projectsoma/FW10/Planos/Adaptaciones/PlanoSM1.pdf

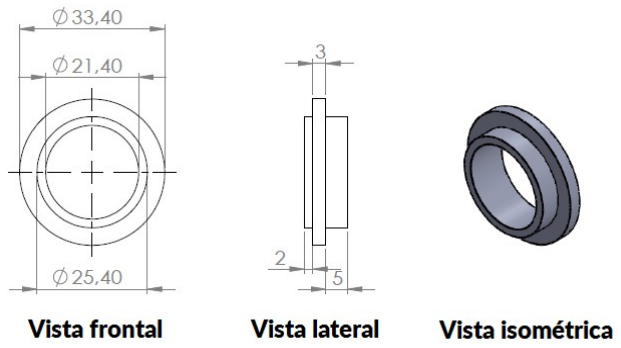
[picture p3: figure]

Adaptador SM1 - 1'
Escala | 1:1
Material | Aluminio
Medidas | Milímetros
