projectsoma/FW10/Planos/Bujes y Ejes/PlanoBujeExterno.PDF

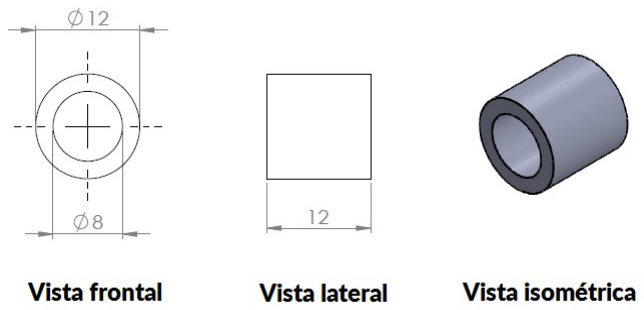
[picture p4: figure]

Buje Externo
Escala | 2:1
Material | Bronce
Medidas | Milímetros
