projectsoma/FW10/Planos/Bujes y Ejes/PlanoEjePinion.pdf

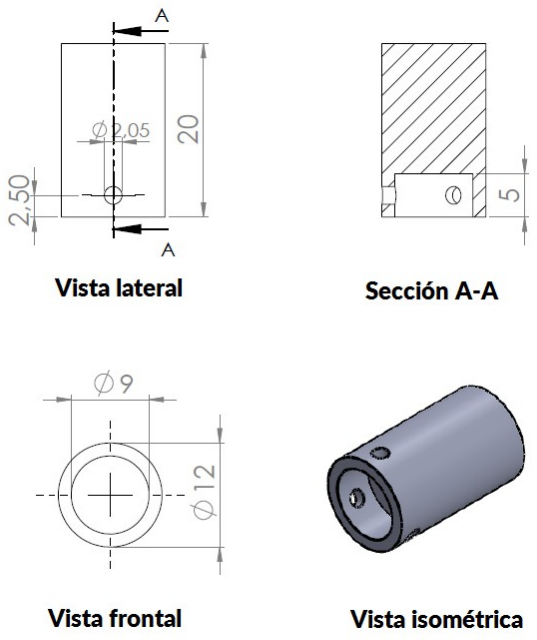
[picture p5: figure]

Eje Pinión - Motor
Escala | 2:1
Material | Bronce
Medidas | Milímetros
