projectsoma/FW10/Planos/Bujes y Ejes/PlanoEjeRueda.pdf

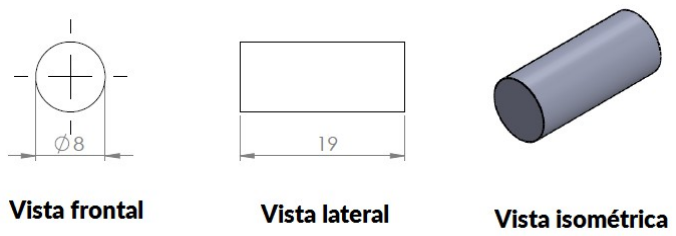
[picture p6: figure]

Eje Rueda
Escala | 2:1
Material | Bronce
Medidas | Milímetros
