projectsoma/FW10/Planos/Carcasa/PlanoContratapaCarcasa.pdf

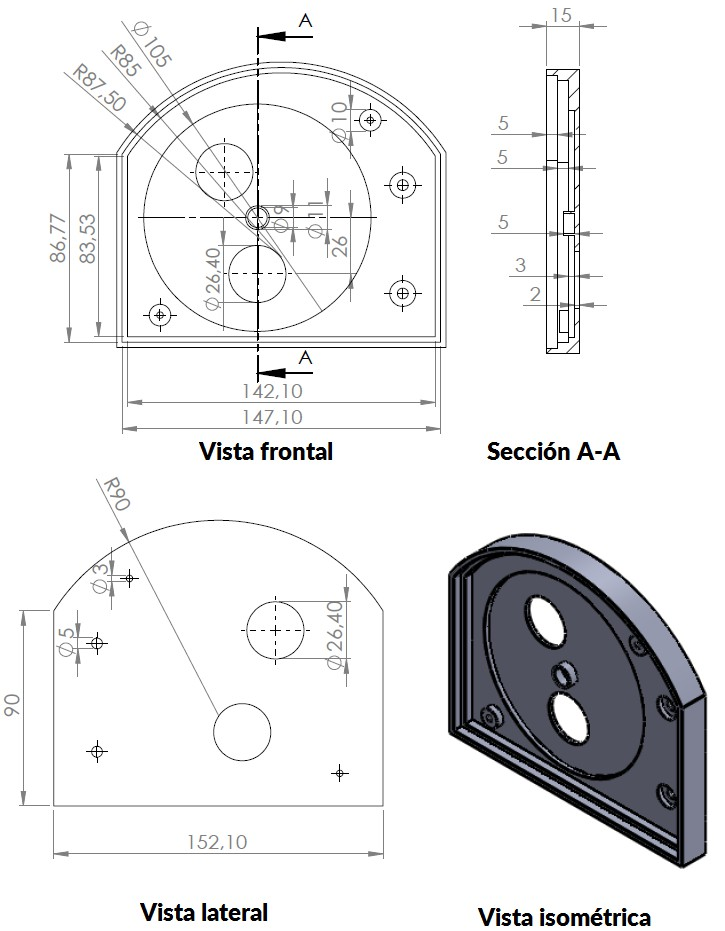
[picture p7: figure]

Contratapa Carcasa
Escala | 1:2
Material | ABS
Medidas | Milímetros
