projectsoma/FW10/Planos/Carcasa/PlanoObturadorCarcasa.pdf

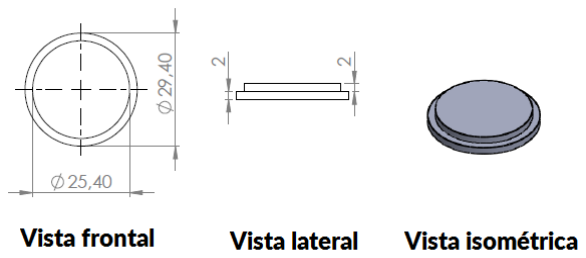
[picture p8: figure]

Obturador Carcasa
Escala | 1:1
Material | ABS
Medidas | Milímetros
