projectsoma/FW10/Planos/Carcasa/PlanoTapaCarcasa.pdf

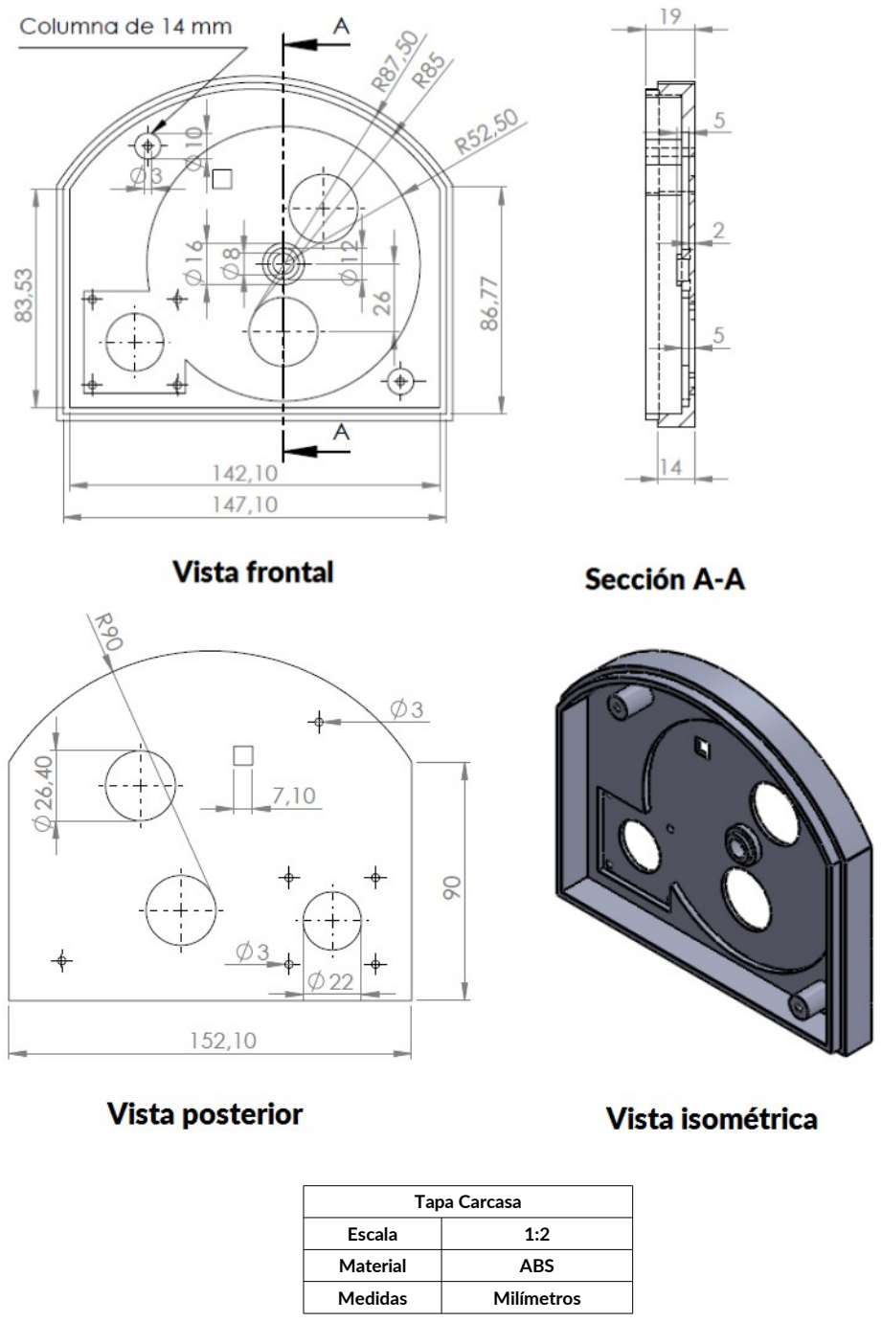
[picture p9: page 1]

Tapa Carcasa
Escala | 1:2
Material | ABS
Medidas | Milímetros
