projectsoma/FW10/Planos/Rueda/PlanoTapaRueda.pdf

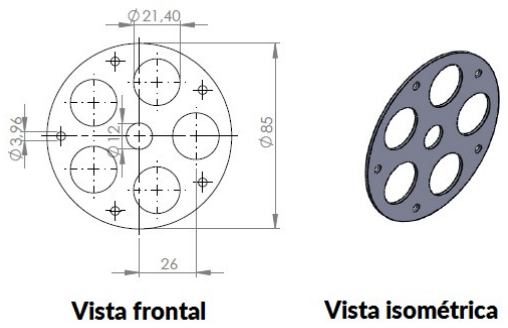
[picture p10: figure]

Tapa Rueda de 1.5 mm de espesor
Escala | 1:2
Material | ABS
Medidas | Milímetros
