projectsoma/FW10/Planos/Rueda/PlanoPinion.pdf

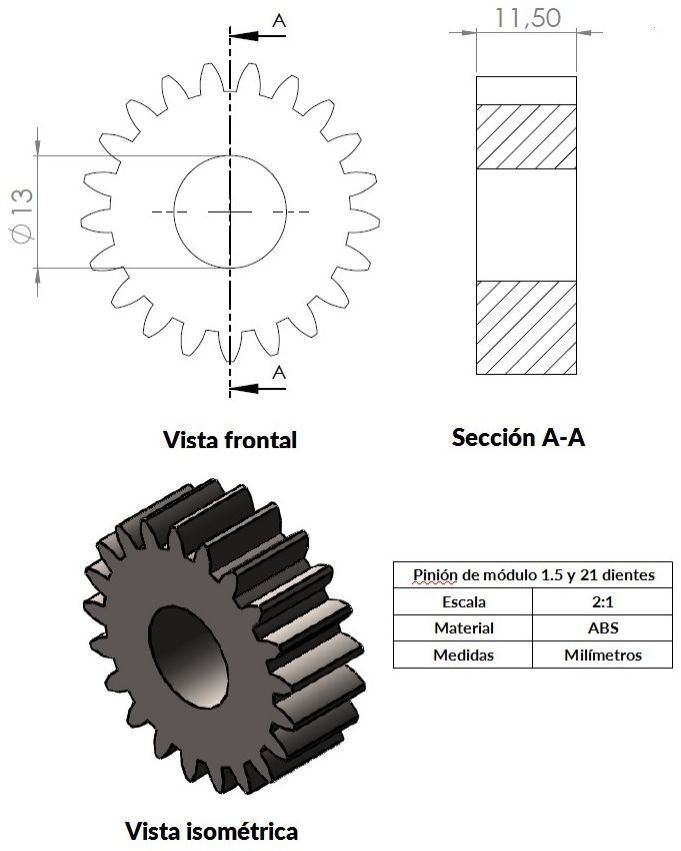
[picture p11: figure]
