projectsoma/FW10/Planos/Rueda/PlanoRueda.pdf

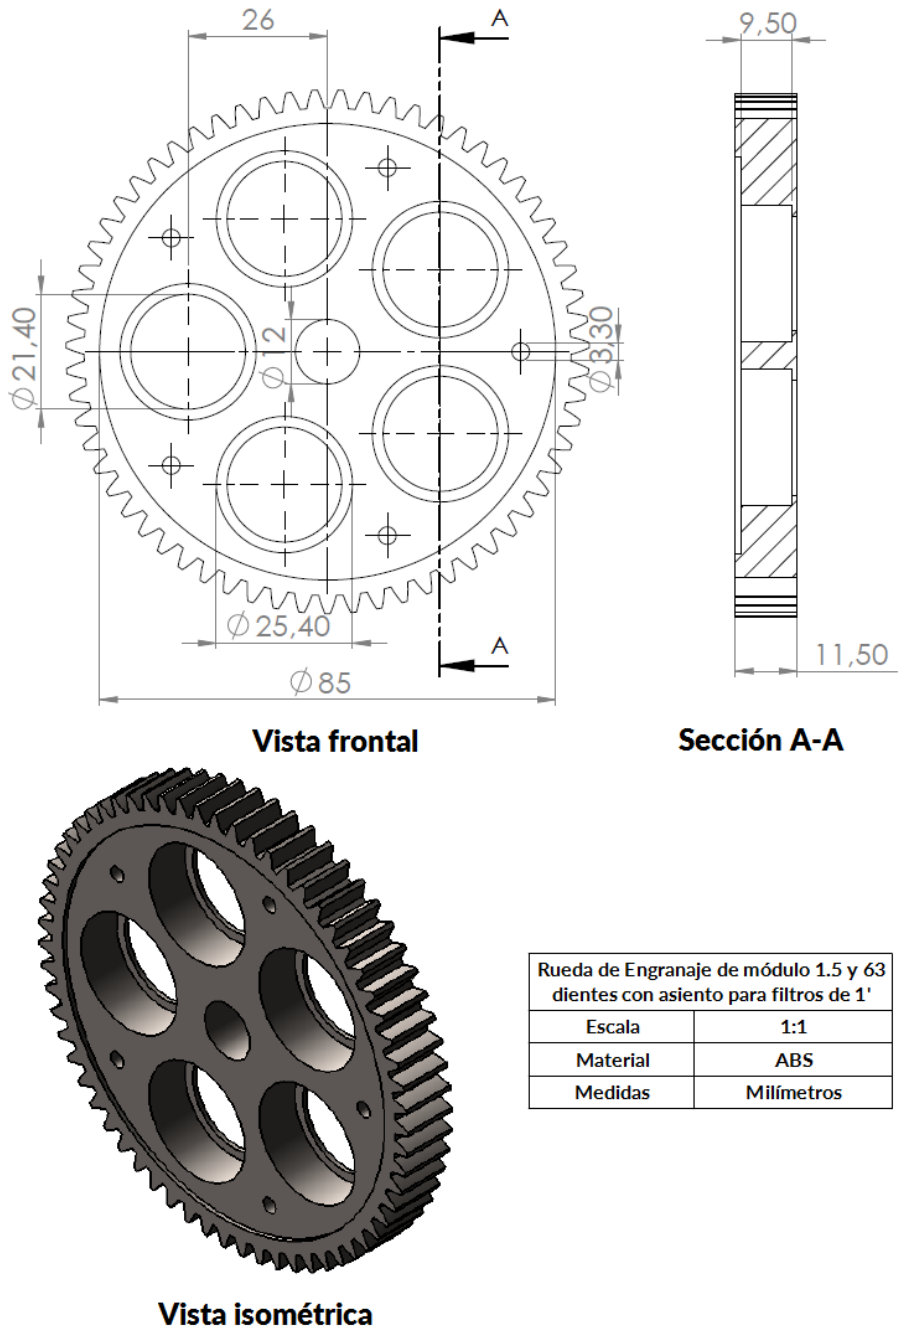
[picture p12: page 1]
