projectsoma/FW10/Vistas 3D/Pinon.STL

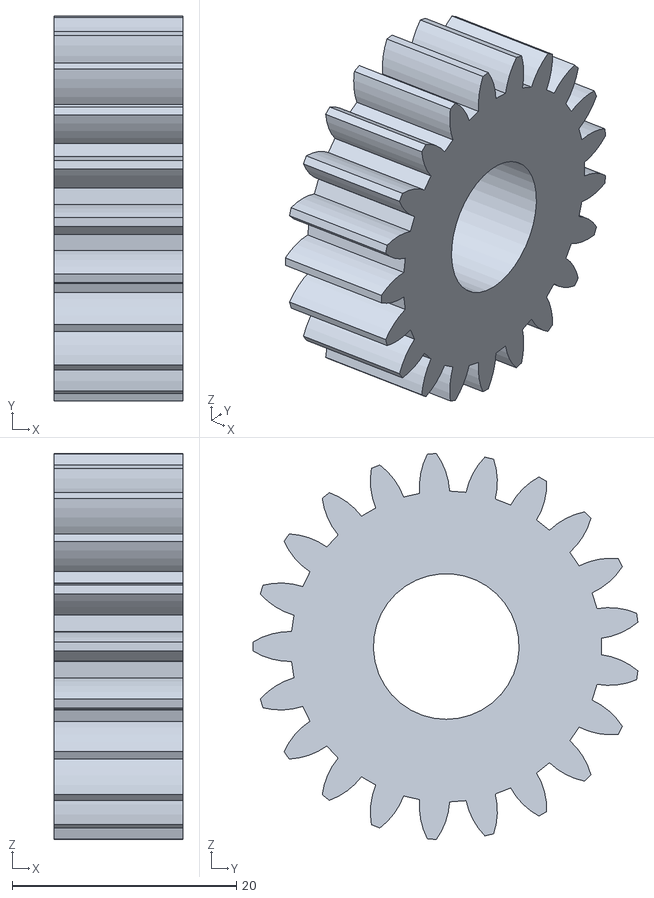
[picture p13: CAD file, 2015-06-14]
Vistas 3D/Pinon.STL
11.5 x 34.4 x 34.5
