projectsoma/FW10/Vistas 3D/Contratapa_Carcasa.STL

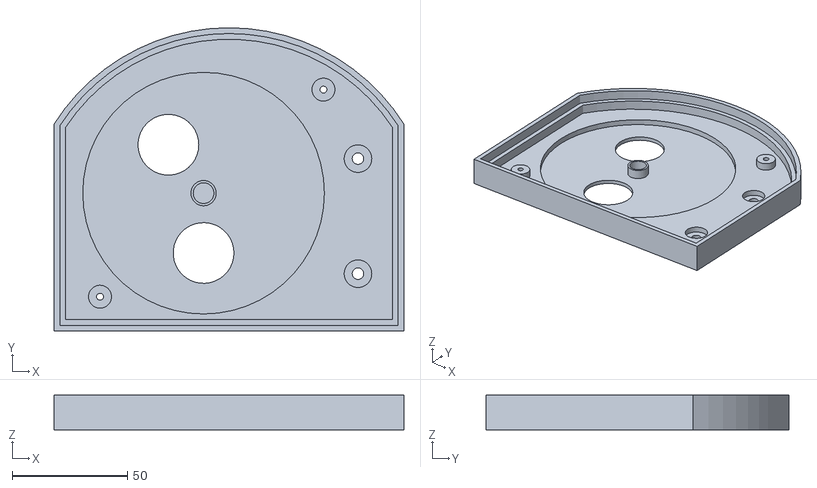
[picture p14: CAD file, 2015-06-14]
Vistas 3D/Contratapa_Carcasa.STL
152.1 x 131.9 x 15.0
