projectsoma/FW10/Vistas 3D/Obturador.STL

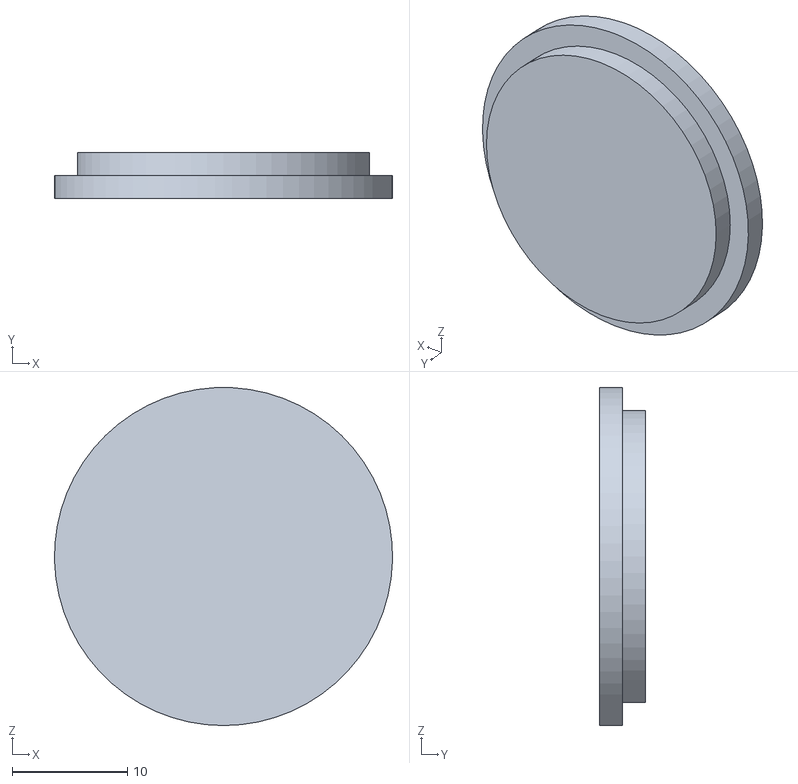
[picture p15: CAD file, 2015-06-14]
Vistas 3D/Obturador.STL
29.4 x 4.00 x 29.4
