projectsoma/FW10/Vistas 3D/Tapa_Rueda.STL

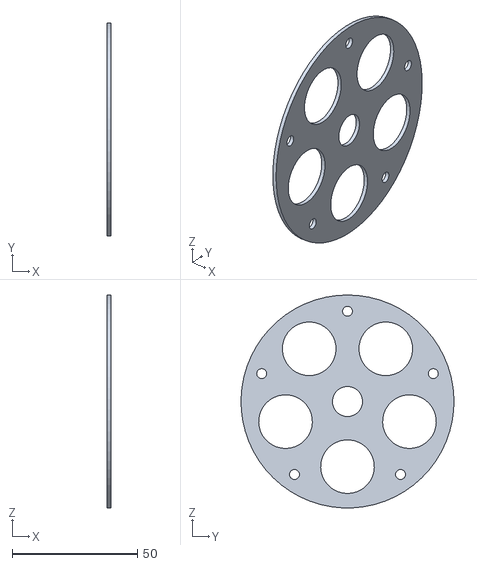
[picture p16: CAD file, 2015-06-14]
Vistas 3D/Tapa_Rueda.STL
1.50 x 85.0 x 85.0
