projectsoma/FW10/Vistas 3D/Rueda_Filtro.STL

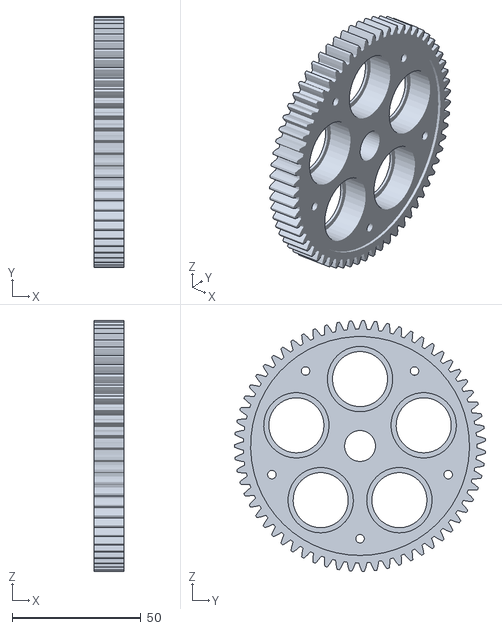
[picture p17: CAD file, 2015-06-14]
Vistas 3D/Rueda_Filtro.STL
11.5 x 97.5 x 97.5
