projectsoma/FW10/Vistas 3D/Tapa_Carcasa.STL

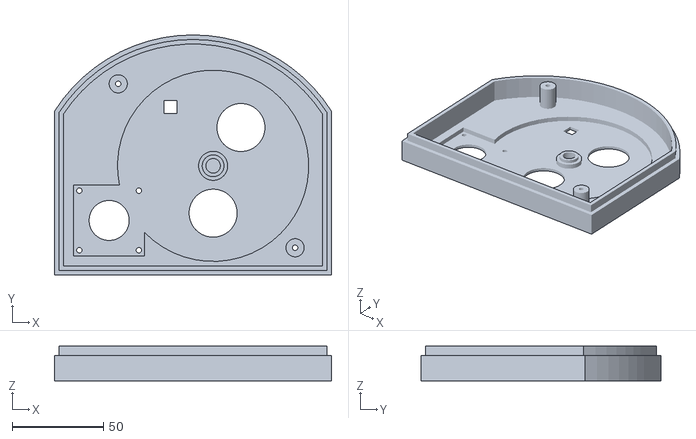
[picture p18: CAD file, 2015-06-14]
Vistas 3D/Tapa_Carcasa.STL
152.1 x 131.9 x 19.0
