projectsoma/FW10/(list of files, cad)

Other CAD files:
Planos/Adaptaciones/PlanoSm1-2mm.SLDDRW
Planos/Bujes y Ejes/PlanoBuje Externo.SLDDRW
Planos/Bujes y Ejes/PlanoBujeInterno.SLDDRW
Planos/Bujes y Ejes/PlanoEjeMotor.SLDDRW
Planos/Rueda/PlanoPinion.SLDDRW
Planos/Rueda/PlanoTapa.SLDDRW
